nickbild/fpga_vga_text_mode/media/screen.jpg

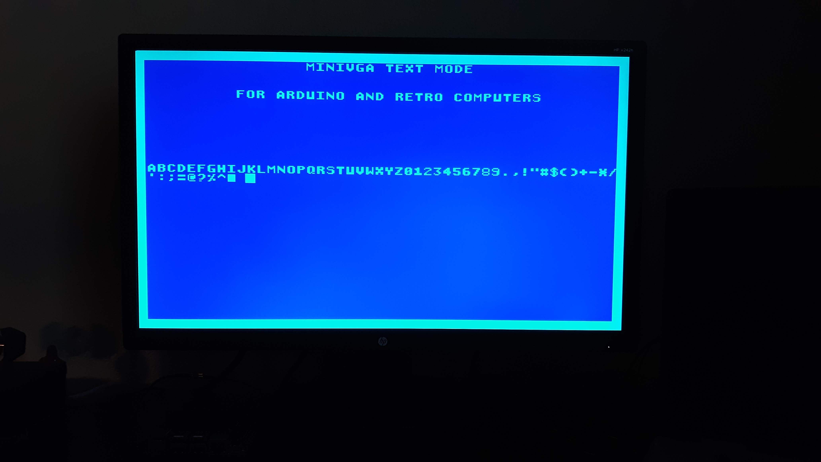
media/screen.jpg
