nickbild/fpga_vga_text_mode/media/screen_close.jpg

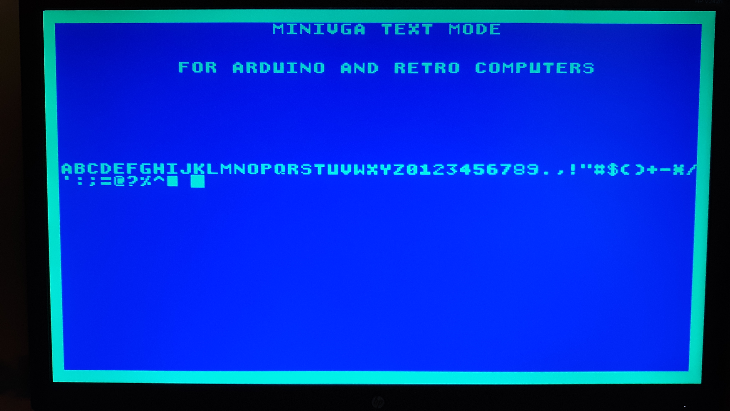
media/screen_close.jpg
