nickbild/fpga_vga_text_mode/media/screen_close_sm.jpg

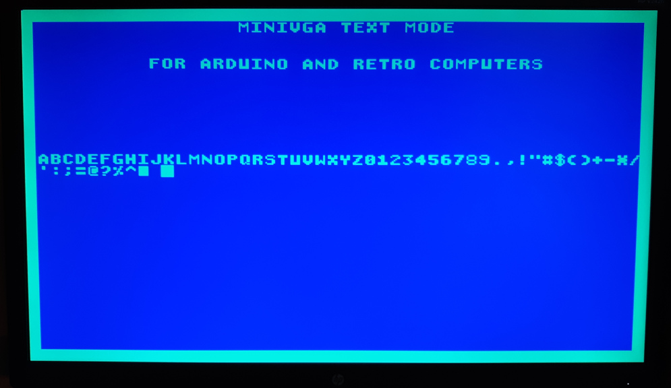
media/screen_close_sm.jpg
