nickbild/fpga_vga_text_mode/(commit log)

2020-10-13 Add Arduino example.
2020-11-04 Add non-zero 'A' and streamline interrupt.
2020-11-08 Switch to ASCII codes.
